msussek/sodamat/SodaMat/stl/03_6x_Sirupschlauchadapter.stl

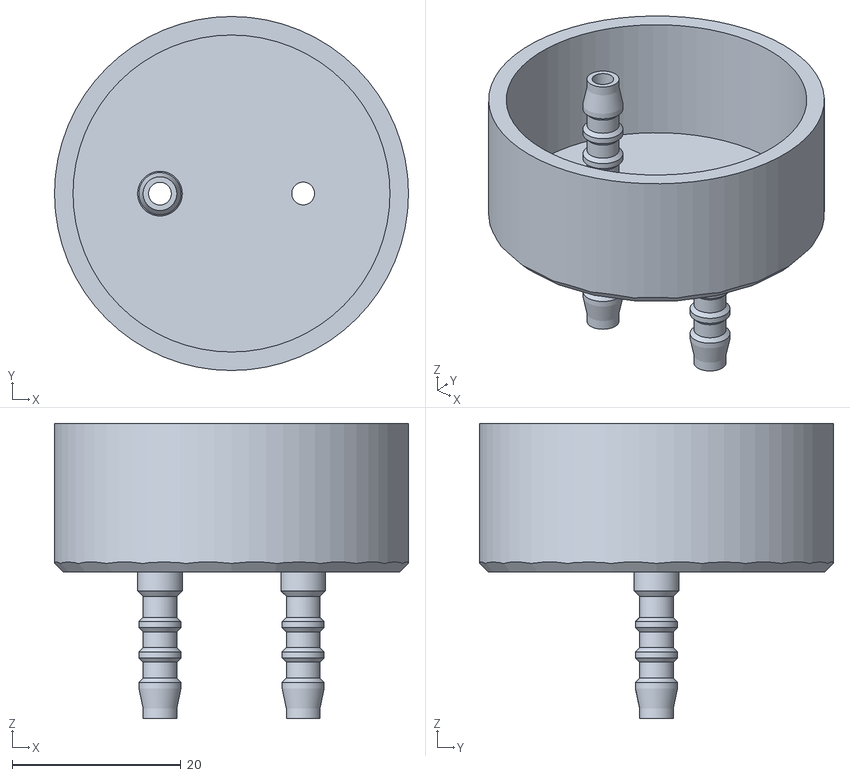
[picture p20: CAD file, 2020-06-04]
SodaMat/stl/03_6x_Sirupschlauchadapter.stl
42.0 x 42.0 x 35.0
