msussek/sodamat/SodaMat/stl/11_Soda_Mat_Schablone.stl

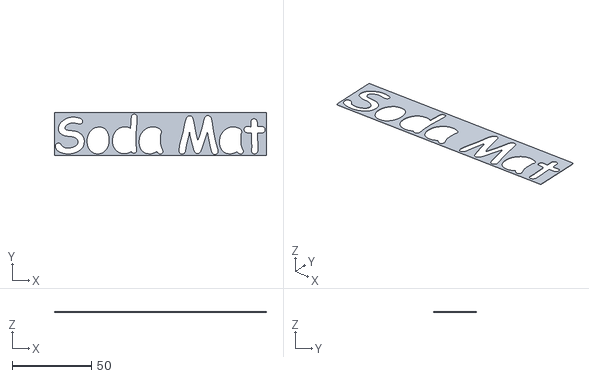
[picture p21: CAD file, 2020-06-04]
SodaMat/stl/11_Soda_Mat_Schablone.stl
134.0 x 27.0 x 0.6
