msussek/sodamat/SodaMat/stl/10_Soda_Mat_Label.stl

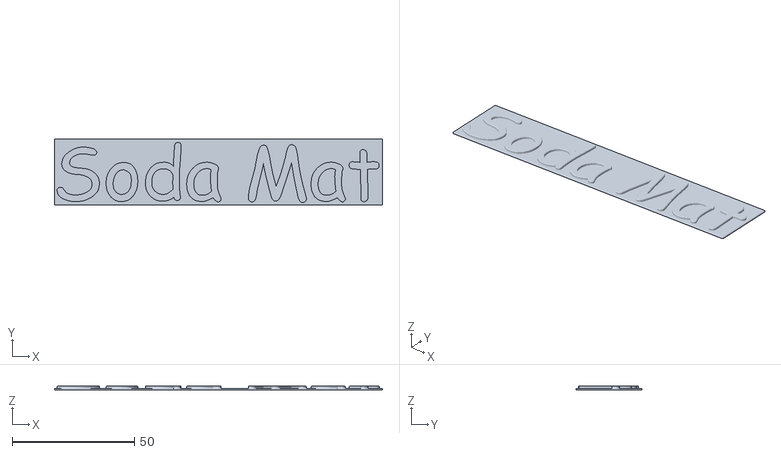
[picture p22: CAD file, 2020-06-04]
SodaMat/stl/10_Soda_Mat_Label.stl
134.0 x 27.0 x 1.60
