msussek/sodamat/SodaMat/stl/07_Potentiometergehäuse_Montagerahmen.stl

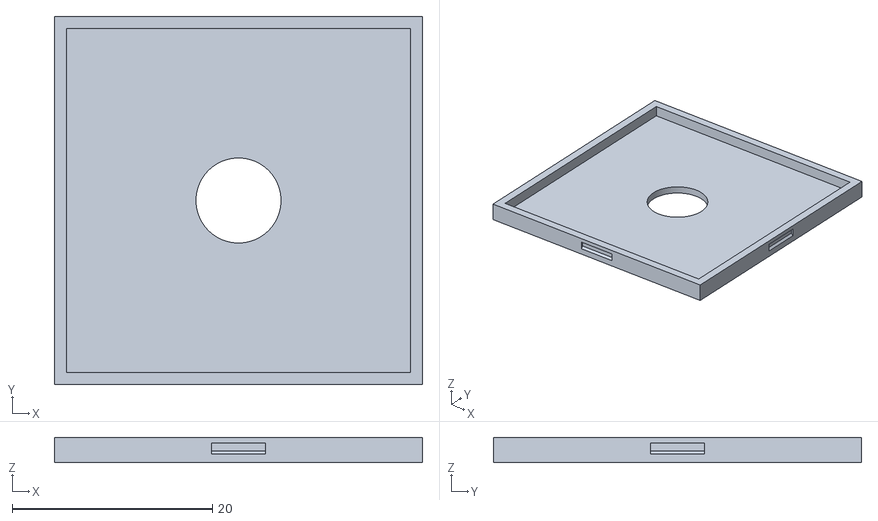
[picture p23: CAD file, 2020-06-04]
SodaMat/stl/07_Potentiometergehäuse_Montagerahmen.stl
36.8 x 36.8 x 2.50
