msussek/sodamat/SodaMat/stl/05_2x_Tastergehäuse_Montagerahmen.stl

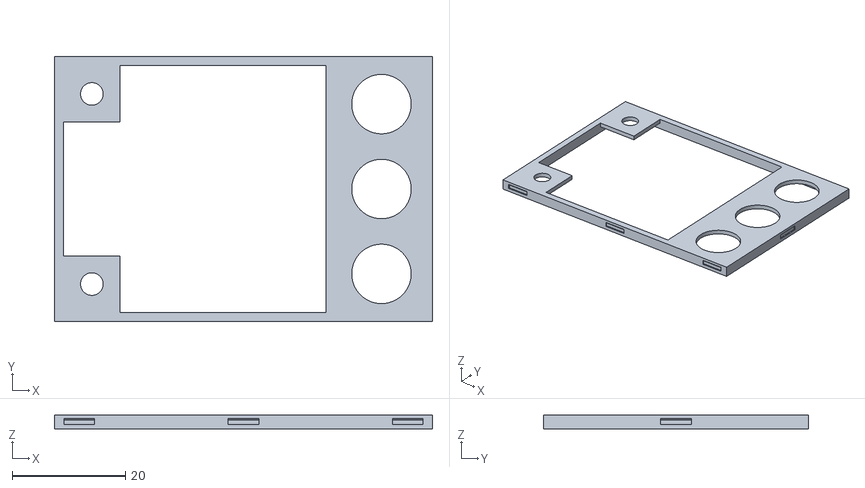
[picture p24: CAD file, 2020-06-04]
SodaMat/stl/05_2x_Tastergehäuse_Montagerahmen.stl
66.8 x 46.8 x 2.50
