msussek/sodamat/SodaMat/stl/06_Potentiometergehäuse_Frontplatte.stl

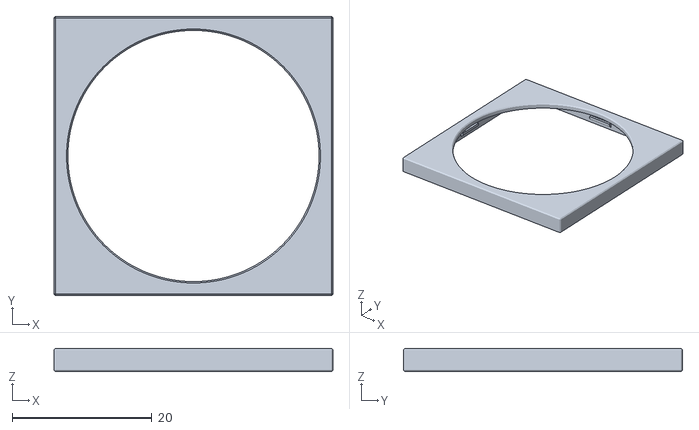
[picture p25: CAD file, 2020-06-04]
SodaMat/stl/06_Potentiometergehäuse_Frontplatte.stl
40.0 x 40.0 x 3.30
