msussek/sodamat/SodaMat/stl/01_Getränkedüse_mit_6_Schlauchdurchführungen.stl

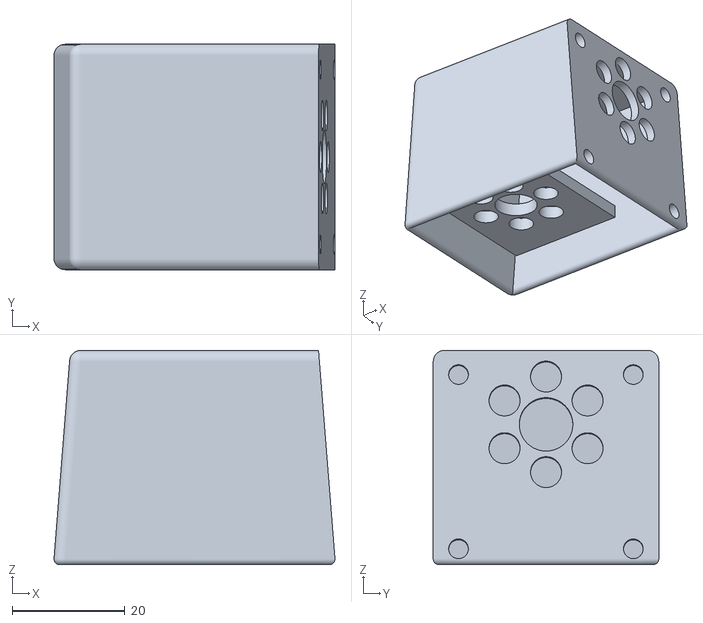
[picture p26: CAD file, 2020-06-04]
SodaMat/stl/01_Getränkedüse_mit_6_Schlauchdurchführungen.stl
49.8 x 40.0 x 38.0
