msussek/sodamat/SodaMat/stl/04_2x_Tastergehäuse_Frontplatte.stl

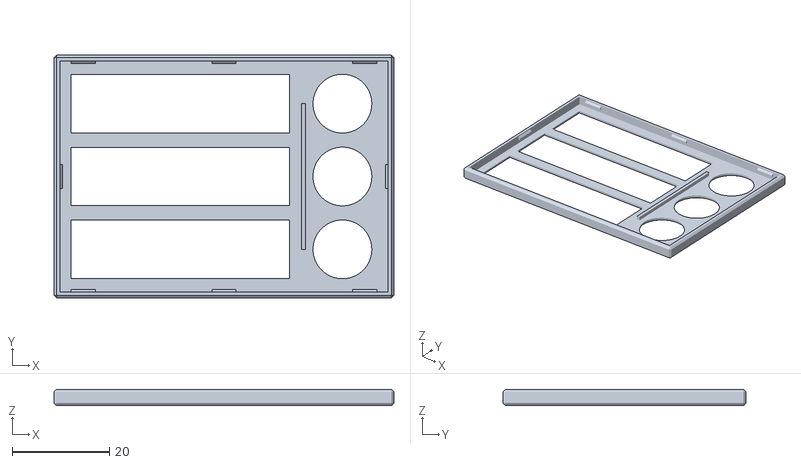
[picture p27: CAD file, 2020-06-04]
SodaMat/stl/04_2x_Tastergehäuse_Frontplatte.stl
70.0 x 50.0 x 3.30
