msussek/sodamat/SodaMat/stl/08_Potentiometer_Drehknopf.stl

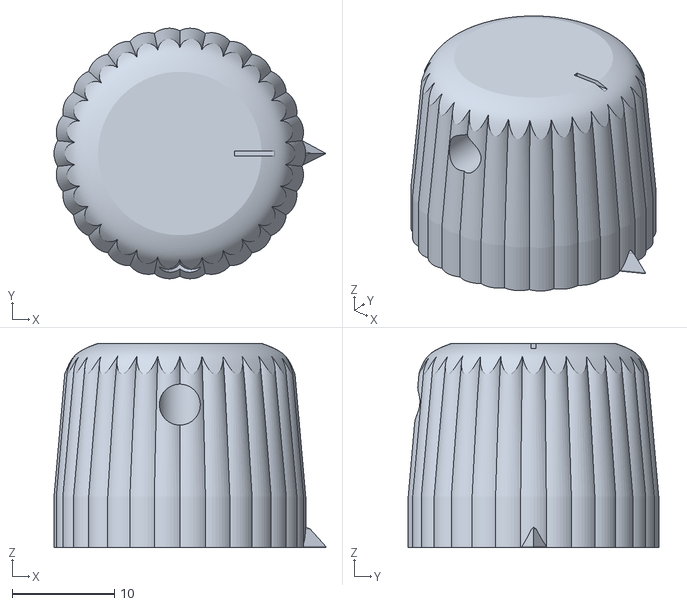
[picture p28: CAD file, 2020-06-04]
SodaMat/stl/08_Potentiometer_Drehknopf.stl
26.6 x 24.5 x 20.0
