msussek/sodamat/SodaMat/stl/09_Ikea_365+_Unterstellrahmen.stl

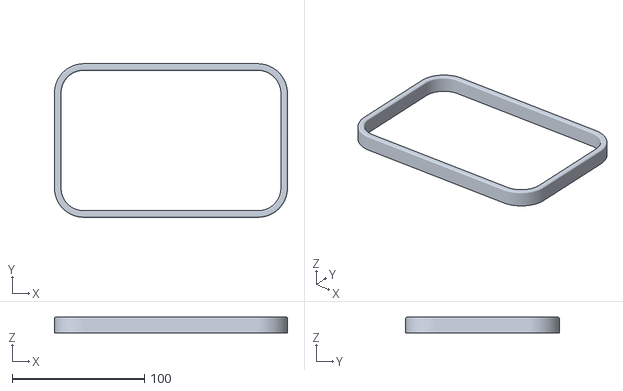
[picture p29: CAD file, 2020-06-04]
SodaMat/stl/09_Ikea_365+_Unterstellrahmen.stl
176.0 x 116.0 x 12.0
