msussek/sodamat/SodaMat/stl/02_6x_Pumpenhalterung.stl

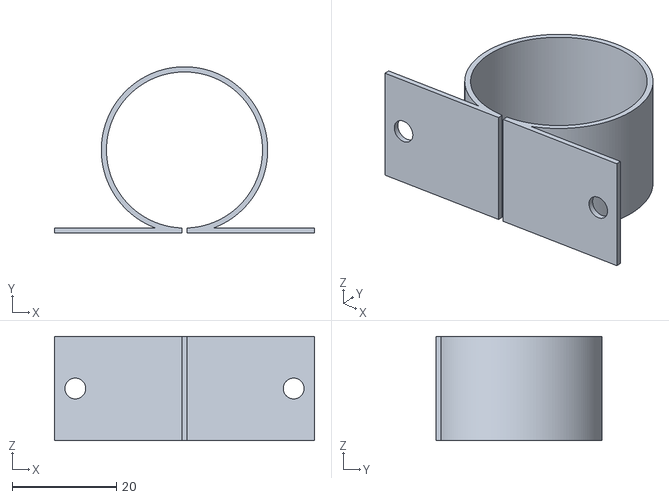
[picture p30: CAD file, 2020-06-04]
SodaMat/stl/02_6x_Pumpenhalterung.stl
50.0 x 32.0 x 20.0
